projectsinmotion/Adding-Heated-and-Vented-Seat-Buttons/MOUNTING.md

# Mounting

For the first few years of production, it seems as though Ram offered two styles of center console faceplates in the fifth generation 1500, one with the USB ports and Aux In off to the right to allow a CD player or a storage pocket on the left, and one with those ports centered, shown here: 

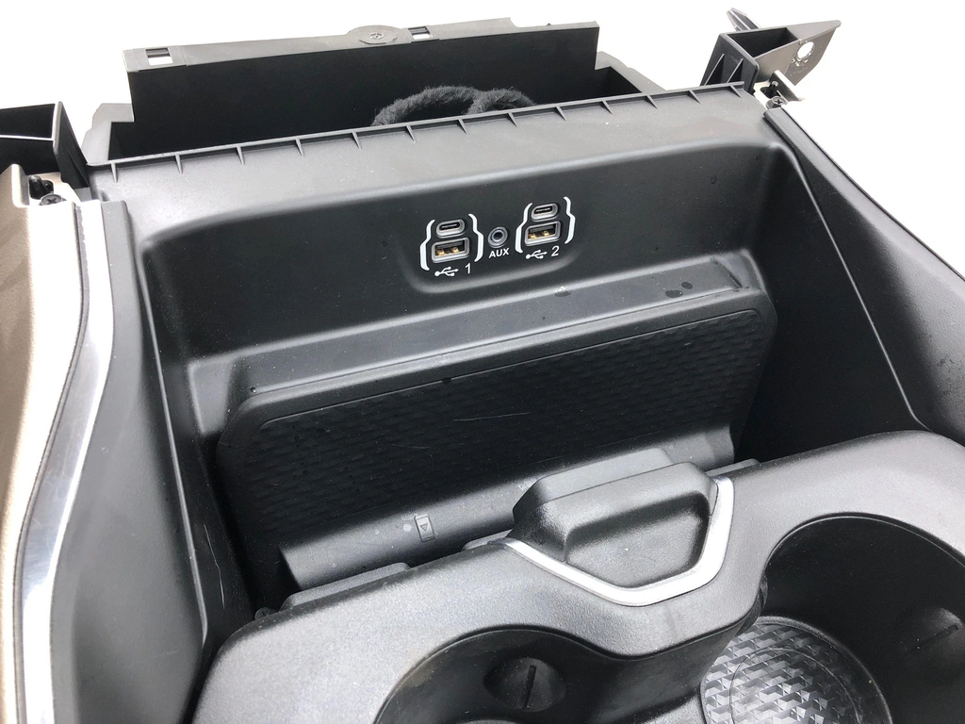
[picture p1: images/center_console_centered_ports.png]
Center console faceplate with centered ports


Some trucks came equipped with the optional wireless phone charger, and it also seems as though the wireless charger faceplates were only made with the USB and Aux In ports off to the right side, shown here:

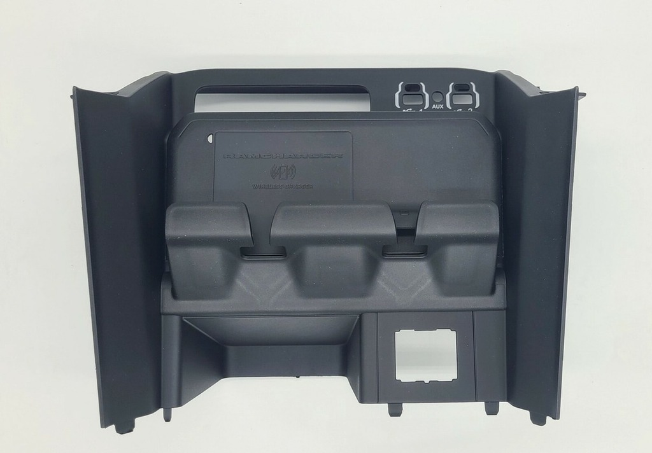
[picture p2: images/center_console_wireless_charger.jpg]
Center console faceplate with wireless charger


To retain the wireless charger but center the USB and Aux In ports, to install the seat button modules symmetrically, the relevant part of the faceplate must be scavenged from a center console faceplate with centered ports, and then installed on a faceplate with the wireless charger.

Start by cutting the relevant part out of the donor faceplate and smoothing out the cut edges to get something like the following:

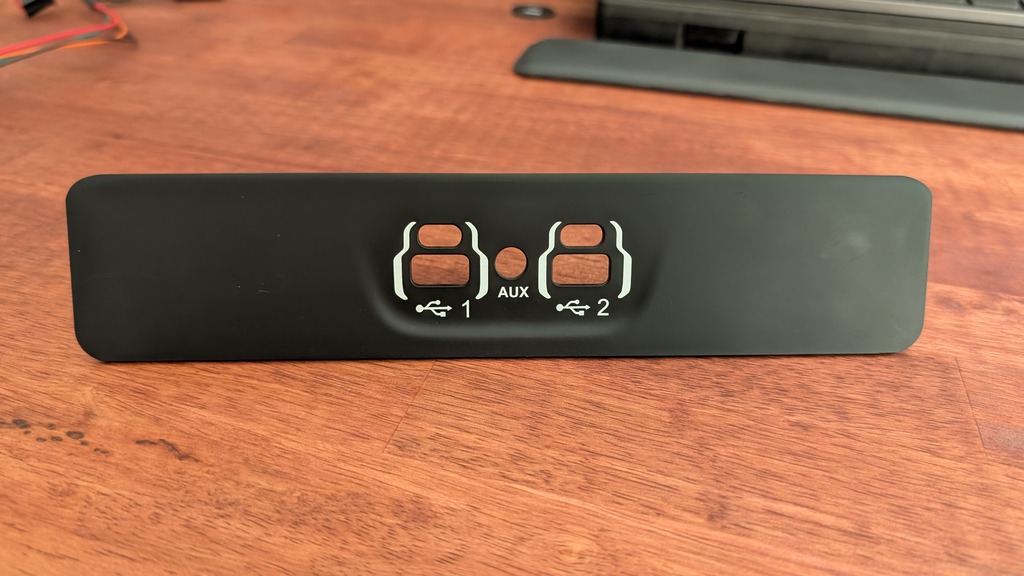
[picture p3: images/mounting_panel_start.jpg]
Mounting panel starting point


To simplify the project, the buttons used are the buttons from the same vehicle, but only used for the rear seats, shown here:

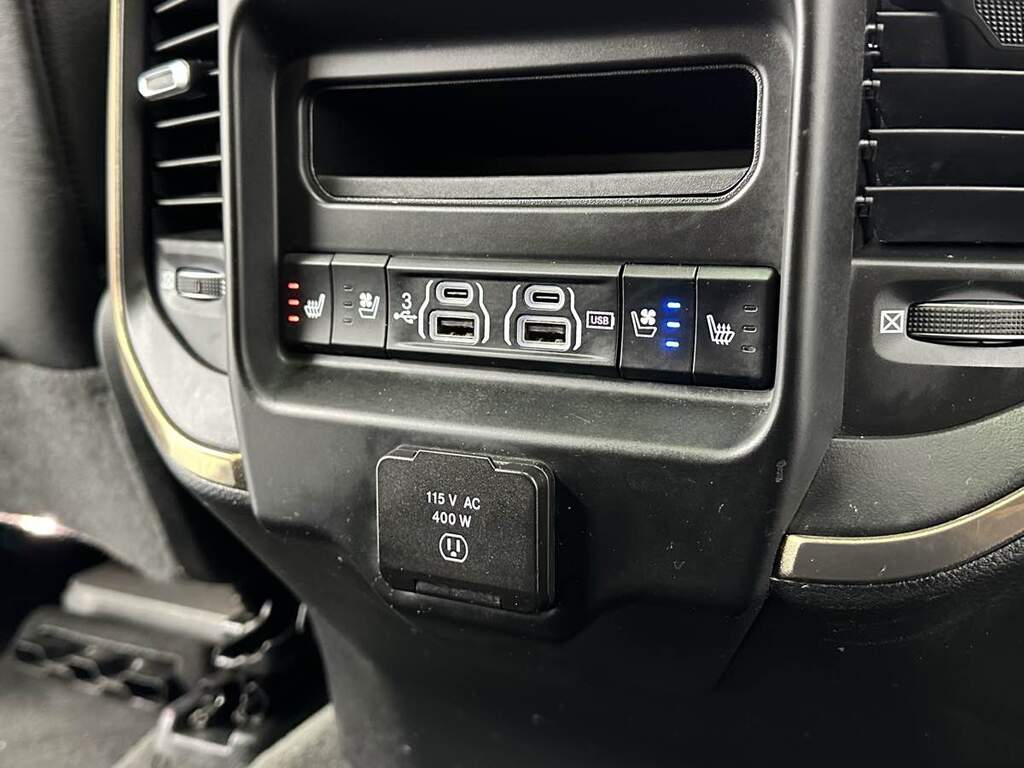
[picture p4: images/center_console_rear_seat_buttons.jpg]
Center console rear seat buttons


Note that the USB ports at the rear of the center console do not use the same module as the ones at the front of the center console, so transplanting the assembly of buttons and ports from the rear to the front is not easily done.

The mounting flanges on the button modules are at the top and bottom, and extend too far to be installed on either side of the ports in the center console faceplate. The rears of the button modules and the mounting flanges are shown here:

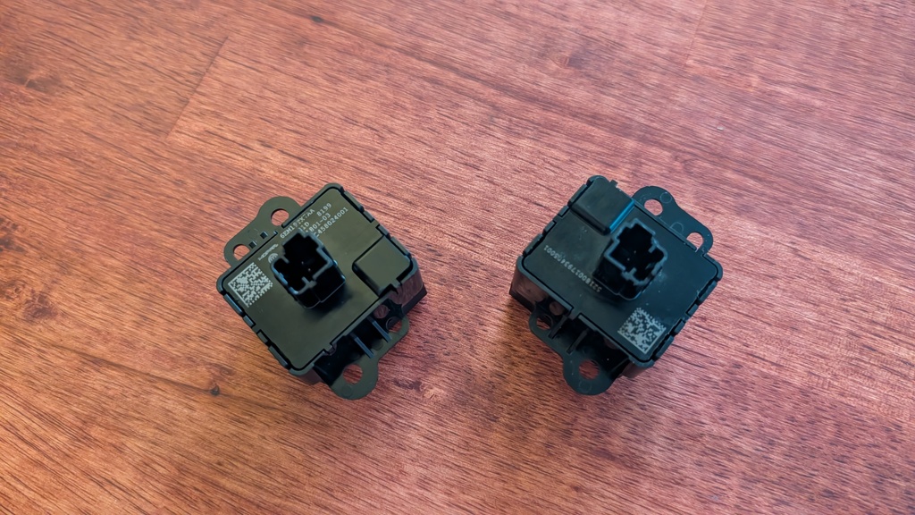
[picture p5: images/buttons_unmodified.jpg]
Stock button modules


The mounting flanges need to be completely removed, and [**these mounting flanges**](https://cad.onshape.com/documents/5132d3ba81357ba5c9de6664/w/01ddbd30e18f7d29c6d44511/e/b6893859f852cbca466a3d6f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) bonded in their place, shown here:

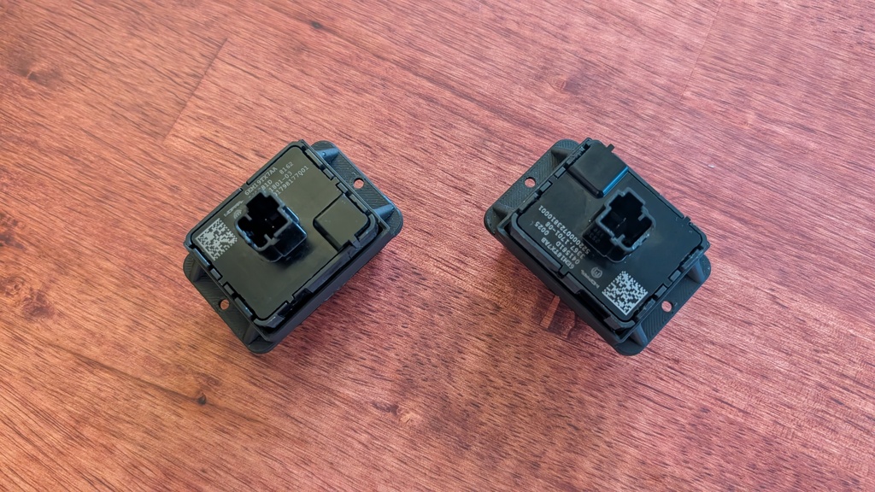
[picture p6: images/buttons_modified.jpg]
Modified button modules


Remove appropriately sized and located sections of the scavenged panel where the button modules will reside, to get something like the following:

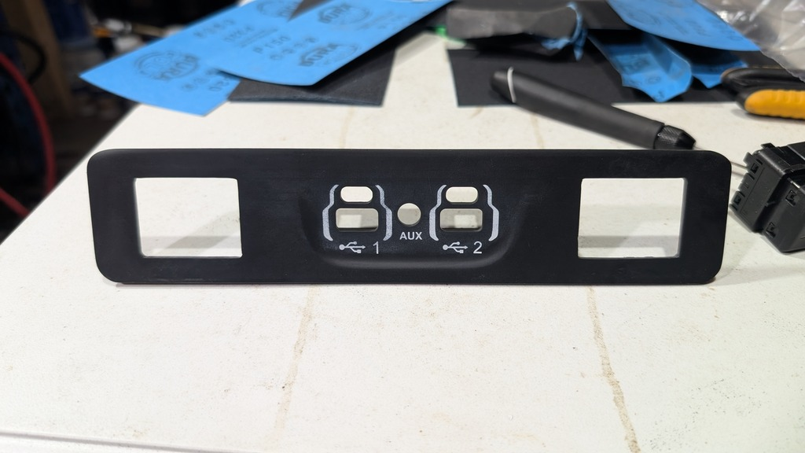
[picture p7: images/mounting_panel_material_removed.jpg]
Mounting panel with rectangular openings


Bond [**these mounting bases**](https://cad.onshape.com/documents/5132d3ba81357ba5c9de6664/w/01ddbd30e18f7d29c6d44511/e/731e55fb501fd2d6602089eb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) to the back of panel, aligned with the new openings, to get something like the following:

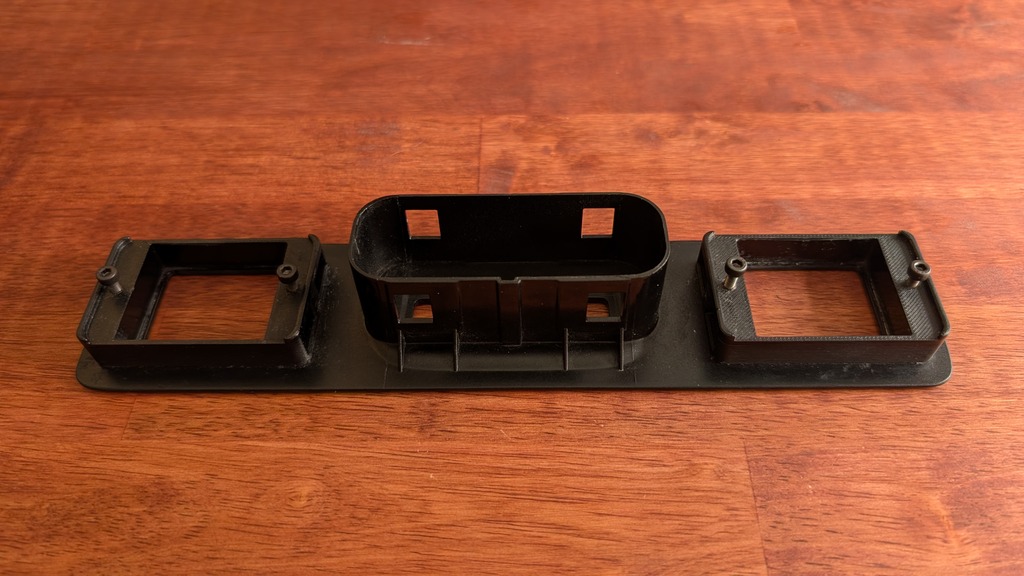
[picture p8: images/mounting_panel_rear_view.jpg]
Mounting panel with new button module mounts


Test fitting the modified button modules into the modified panel, securing them with M3x0.5 bolts with 10mm shanks, should look something like the following:

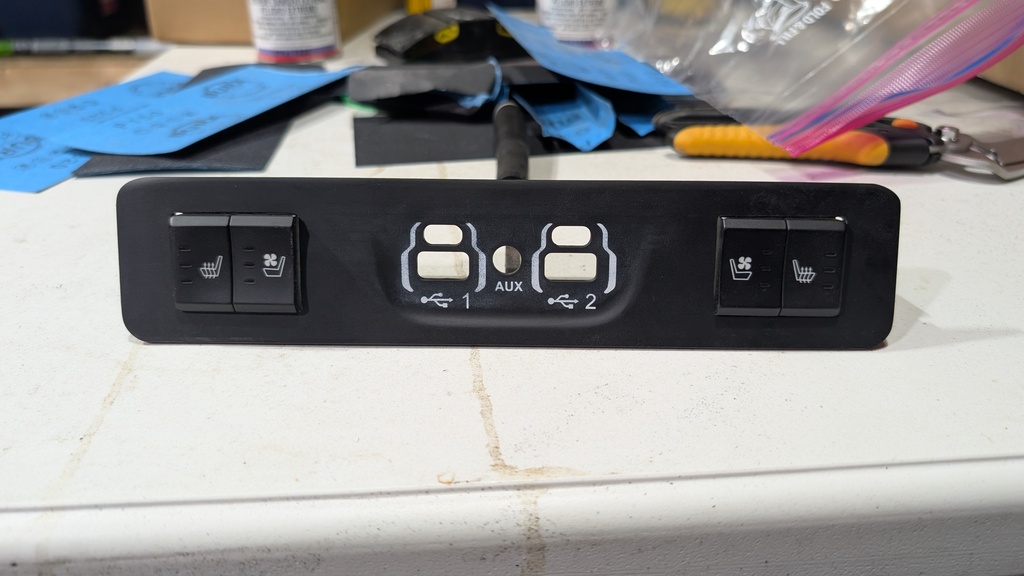
[picture p9: images/mounting_panel_test_fit.jpg]
Mounting panel with new button module mounts


Optionally, the panel can be painted. A complete panel, with button modules and USB / Aux In connection module, should look something like the following:

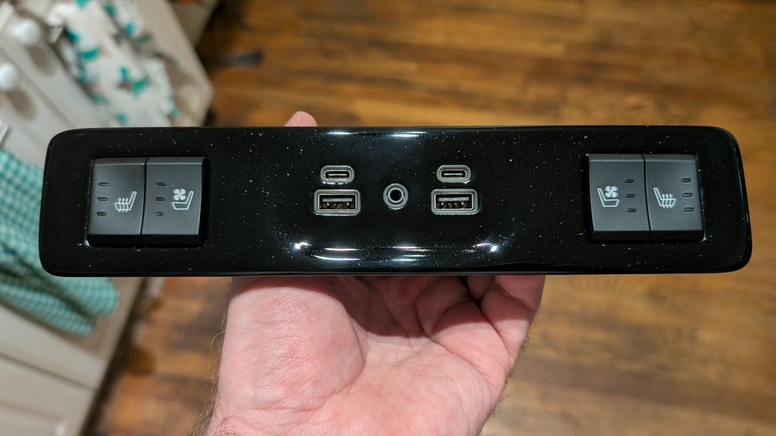
[picture p10: images/mounting_panel_complete.jpg]
Mounting panel finished


Portions of the existing faceplate, where the button modules and mounts as well as the USB / Aux In connection module and mount extend backwards, will need to be removed. The unmodified faceplate is shown here:

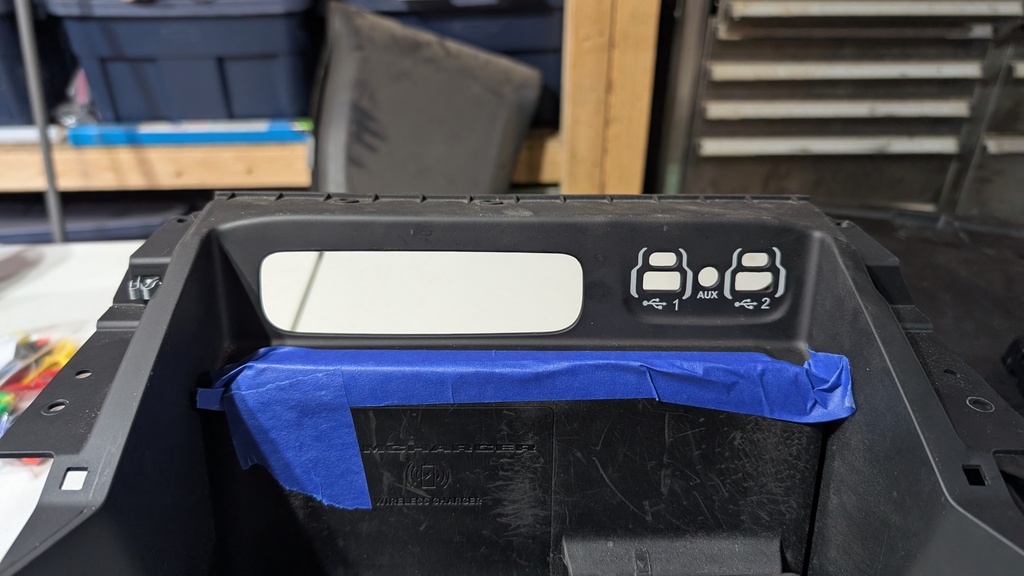
[picture p11: images/old_center_console_face.jpg]
Old center console faceplate


The faceplate with the new panel bonded in place is shown here:

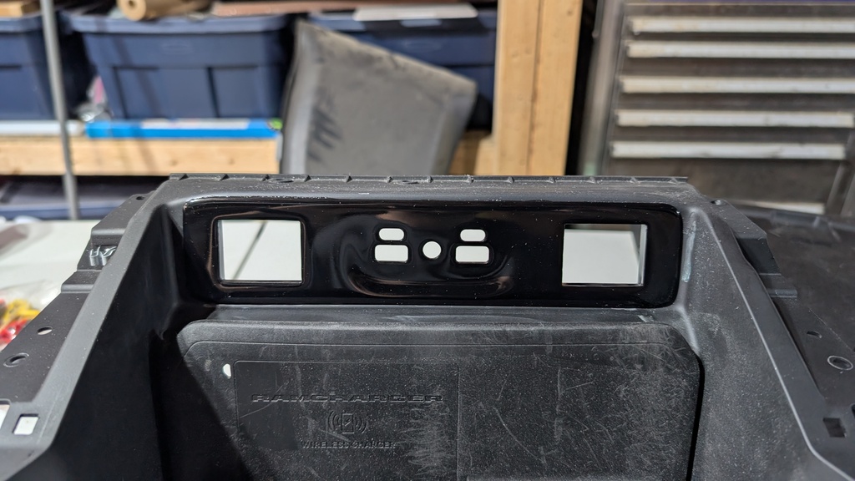
[picture p12: images/new_center_console_face.jpg]
New center console faceplate


With the center console reassembled and installed, the faceplate looks like this:

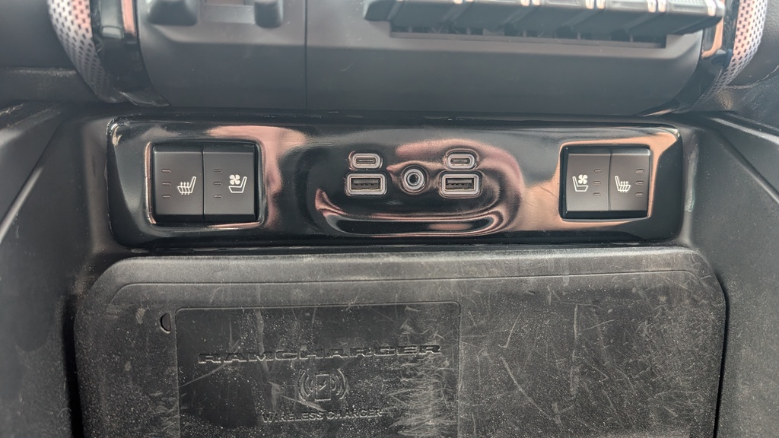
[picture p13: images/mounting_panel_fully_installed.jpg]
Mounting panel fully installed


The board secures to the enclosure body with four M2 bolts and the enclosure lid simply snaps into place:

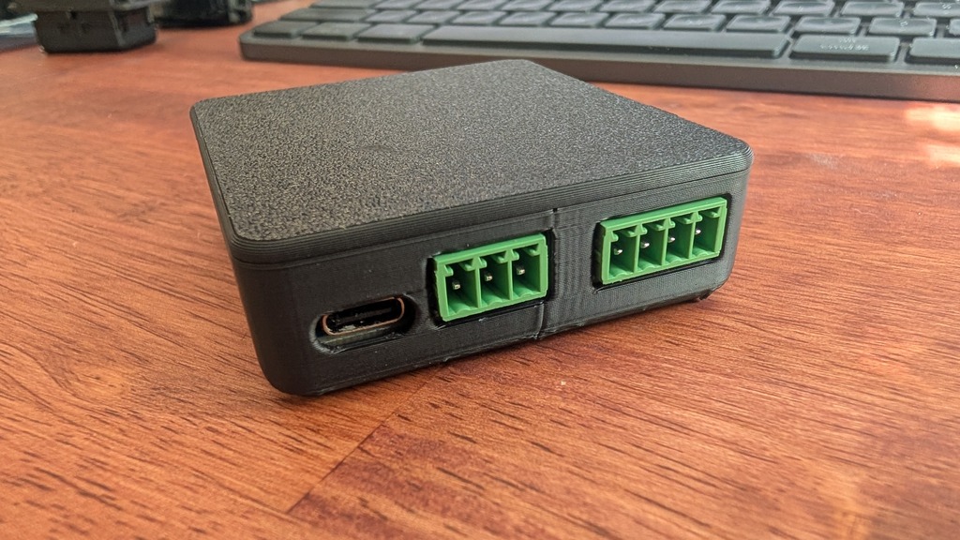
[picture p14: images/board_enclosure.jpg]
Assembled board enclosure


The board enclosure resides behind the touchscreen and can be secured in place with some 3M VHB tape. The wires easily route to this location:

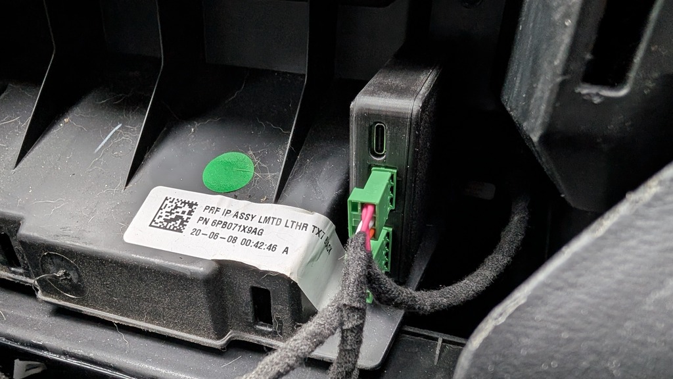
[picture p15: images/board_enclosure_installed.jpg]
Assembled board enclosure
