projectsinmotion/Adding-Heated-and-Vented-Seat-Buttons/cad/step/board_enclosure_body_lin_terminal_qty_4.step

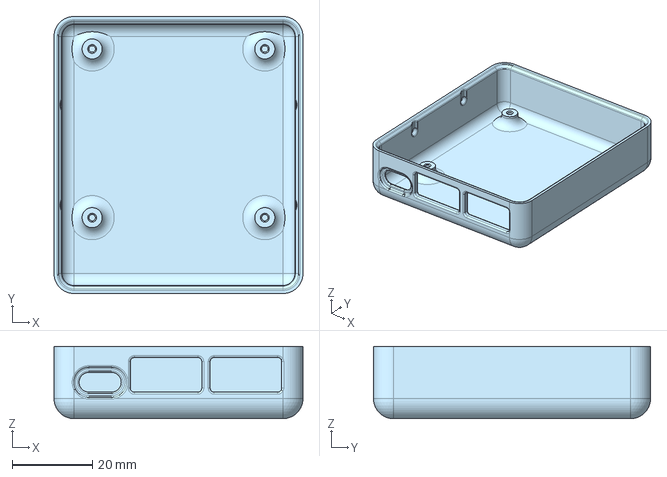
[picture p16: CAD file, 2025-11-20]
cad/step/board_enclosure_body_lin_terminal_qty_4.step
62.0 x 69.0 x 18.0 mm
