projectsinmotion/Adding-Heated-and-Vented-Seat-Buttons/cad/step/button_module_mounting_base.step

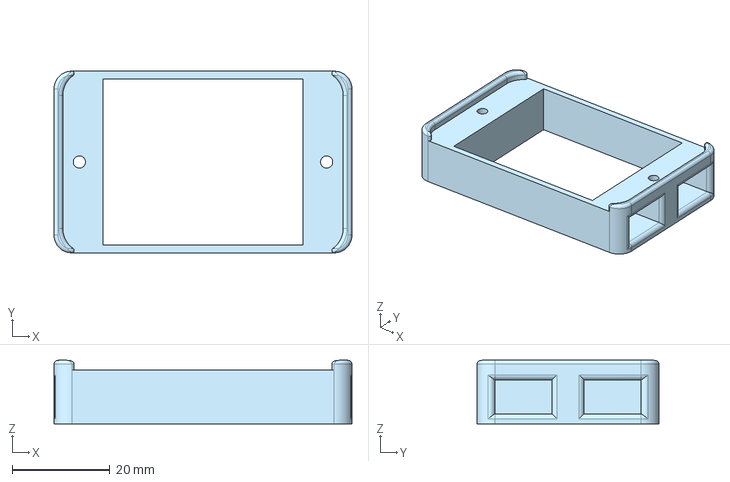
[picture p17: CAD file, 2025-11-20]
cad/step/button_module_mounting_base.step
61.0 x 37.2 x 13.0 mm
