projectsinmotion/Adding-Heated-and-Vented-Seat-Buttons/cad/step/board_enclosure_lid.step

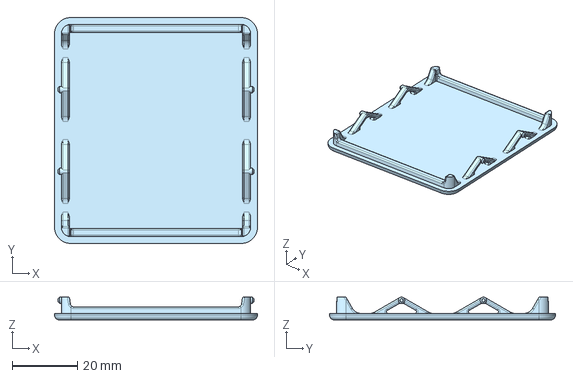
[picture p18: CAD file, 2025-11-20]
cad/step/board_enclosure_lid.step
62.0 x 69.0 x 7.00 mm
