projectsinmotion/Adding-Heated-and-Vented-Seat-Buttons/cad/step/button_module_mounting_flange.step

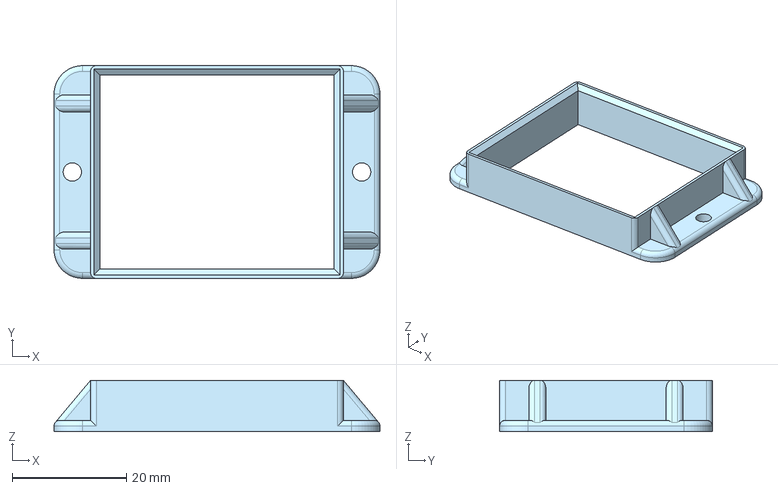
[picture p19: CAD file, 2025-11-20]
cad/step/button_module_mounting_flange.step
57.0 x 37.2 x 9.00 mm
