projectsinmotion/Adding-Heated-and-Vented-Seat-Buttons/(list of files, cad)

Other CAD files:
cad/step/board_enclosure_body_lin_terminal_qty_3.step
cad/stl/board_enclosure_body_lin_terminal_qty_3.stl
cad/stl/board_enclosure_body_lin_terminal_qty_4.stl
cad/stl/board_enclosure_lid.stl
cad/stl/button_module_mounting_base.stl
cad/stl/button_module_mounting_flange.stl
