projectsinmotion/Adding-Heated-and-Vented-Seat-Buttons/(commit log)

2025-11-20 Initial commit: LIN-CAN Gateway for Heated/Ventilated Seat Buttons
    Complete reverse-engineered protocol gateway for integrating repurposed OEM
    heated/ventilated seat button modules into 2020 Ram 1500.
    Features:
    - Bidirectional LIN-CAN protocol translation
    - Button press detection and CAN transmission
    - LED intensity and backlighting control
    - Complete analysis workflow and documentation
    - Test sketches and bus sniffer tools
    [board_enclosure_body_lin_terminal_qty_3.step, board_enclosure_body_lin_terminal_qty_3.stl, board_enclosure_body_lin_terminal_qty_4.step, board_enclosure_body_lin_terminal_qty_4.stl, board_enclosure_lid.step, board_enclosure_lid.stl, button_module_mounting_base.step, button_module_mounting_base.stl]
2025-11-20 Fix image reference case in WIRING.md
    Updated LIN sniffing harness image filename to use lowercase 'lin' to match actual file naming convention.
